Dr-Verdin/Arduino-Human-Following-Robot/README.md

# Arduino-Human-Following-Robot

## Introdução

Projeto de um Arduino Human Following Robot baseado no vídeo ["How To Make Arduino Human Following Robot"](https://www.youtube.com/watch?v=yAV5aZ0unag&t=24s) do DIY Builder.
O material utilizado está disponivel na pasta "Material".

## Lista de Componentes

| Quantidade | Componentes | Valor Unit. (R$) |
|---|---|---|
| 1 | Arduino Uno | [R$44,91](https://www.baudaeletronica.com.br/produto/arduino-uno-atmega328-smd-compativel-cabo-usb.html) |
| 1 | Motor Shield L293D | [R$19,99](https://www.baudaeletronica.com.br/produto/motor-shield-l293d-driver-ponte-h-para-arduino.html) |
| 2 | Kit motor DC 6V + roda para Robô | [R$ 13,41](https://www.baudaeletronica.com.br/produto/kit-motor-dc-roda-para-robo.html) |
| 1 | Servo Motor | [R$11,74](https://www.baudaeletronica.com.br/produto/micro-servo-9g-sg90-tower-pro.html) |
| 1 | Sensor de Distância Ultrassônico | [R$9,20](https://www.baudaeletronica.com.br/produto/sensor-de-distancia-ultrassonico-hc-sr04.html) |
| 2 | Sensor de Obstáculo Infravermelho | [R$6,30](https://www.baudaeletronica.com.br/produto/modulo-sensor-de-obstaculo-infravermelho-ir.html) |
| 2 | Kit 2 Baterias Recarregáveis 18650 3.7V-4.2V Lítio | [R$30,00](https://produto.mercadolivre.com.br/MLB-1792812106-kit-2-bateria-recarregavel-18650-37v-42v-li-ion-lanterna-_JM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) |
| 1 | Suporte para 3 Baterias de Lítio 18650 | [R$18,98](https://produto.mercadolivre.com.br/MLB-2656593580-suporte-case-para-3s-baterias-18650-126v-com-mola-e-fios-_JM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) |
| 1 | kit 40 jumpers fêmea | [R$11,40](https://www.mercadolivre.com.br/cabo-wire-jumper-fmea-x-fmea-20-cm-40pcs/p/MLB28119264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) |
| | Base de acrílico (qualquer uma serve desde que caibá os componentes) | - |
| **TOTAL**  | | R$215,64 |

**Observações:** A maioria dos componentes foi adquirido com o orientador do projeto, ou seja, muito provavelmente pode ter variações de valores em relação aos preços da tabela. 
Os componentes que tivemos que comprar foram 1 Sensor de Obstáculo Infravermelho, 1 Suporte para 3 Baterias de Lítio 18650 e o Motor Shield L293D; Além disso, tivemos que confessionar (em papelão), o "pescoço" e a "cabeça" do robô.

## Tutorial

A seguir estará o passo a passo para a montagem do robô de acordo com a nossa experiência (não necessariamente seguirá a mesma ordem do video base):

1. Primeiramente, depois de escolhermos o projeto que queriamos executar, fomos buscar alguns componentes com o orientador (Simões) da disciplina. Felizmente adquirimos a maioria dos componentes necessários para o projeto e os que faltaram compramos numa loja de eletrônica ou confeccionamos nós mesmos;
2. Já com todos os componentes necessários começamos a montagem, com a base do robô já pronta (Kit motor DC + roda para Robô e base de acrílico) fixamos o Arduino e o Suporte de Bateria em cima;
3. Logo em seguida encaixamos o Motor Shield no Arduino;
4. Começando a montagem da cabeça:
    1. Fizemos peças improvisadas de papelão para a montagem da cabeça, pois o tempo era muito curto para aprendermos à mexer com uma impressora 3D da universidade:

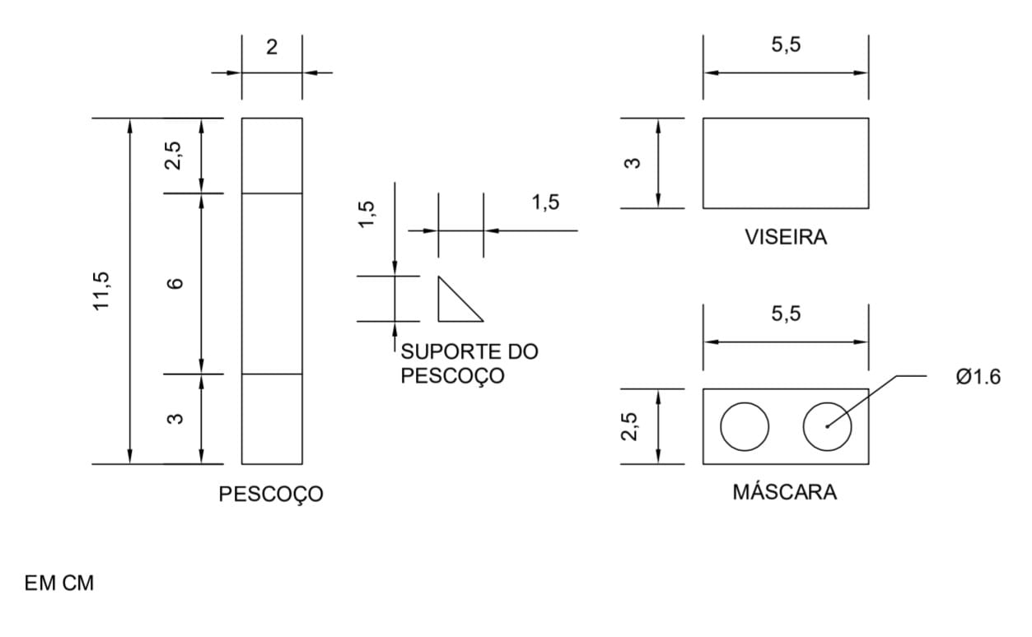
[picture p1: Material/moldes.jpeg]
    

    2. Com as peças já prontas colamos o Servo Motor na base maior do "pescoço";
    3. Para a "cabeça" encaixamos a máscara no Sensor de Distância Ultrassônico e em seguida colamos os dois Sensores de Obstáculo Infravermelhos nas laterias da máscara. Também colamos uma viseira em cima da cabeça;
    4. Com a "cabeça" e o "pescoço" prontos, colamos um no outro e depois fixamos o Servo Motor na frente da base.
5. Em seguida, já com todos os componentes fixados na base fizemos as conecções do circuito com Jumpers:

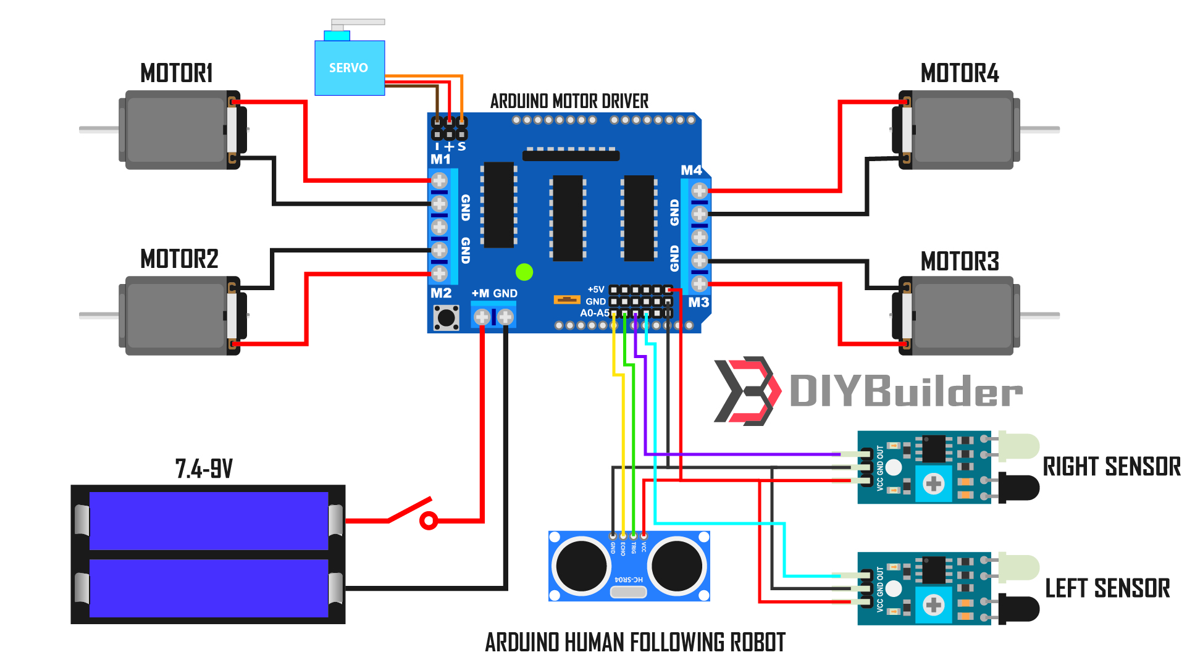
[picture p2: Material/Circuit.jpg]


6. Com todo o Hardware pronto, passamos o código para o Arduino;
7. Voilá o robô está pronto, é só inserir as baterias e se tudo estiver certo ele funcionará. Caso queira é recomendado inserir uma chave para ligar e desligar, com isso não é necessário remover as baterias para desligá-lo.

## Desafios enfretados na execução do projeto

A seguir estará listado as dificuldades que enfrentamos na realização do projeto e como solucionamos esses problemas para conseguir finalizá-lo:

- O vídeo com o projeto original tem origem indiana e foi postado à 4 anos atrás, então tivemos um pequeno trabalho para identificar os componentes e buscar semelhantes caso a necessidade pedisse; 
- Quando compramos os componentes faltantes, acabamos comprando o Suporte de Bateria igual ao do vídeo (de 2 baterias), o que foi um problema mais adiante, pois os motores da base eram de 6V (12V no total, pois só usamos dois motores DC), ou seja, precisava, no nosso caso, de um Suporte de 3 Baterias. Felizmente o nosso orientador tinha esse suporte e não precisamos comprar outro;
- O resto da montagem foi tranquila o próximo problema surgiu na hora de passar o código para o Arduino. Essa foi nossa primeira vez usando um, então tivemos adquirir um conhecimento básico, além disso modificamos o código original ao nosso favor (como o projeto original havia 4 rodas e o nosso somente 2, excluímos as duas rodas em excesso do código original. Ademais diminuímos a velocidade do robô);
- Além disso, os nossos computadores pessoais não conseguiam passar o código para o Arduino (eles não detectavam nenhuma Port), então tivemos que ir no laboratório da universidade para usar os computadores de lá para passar o nosso código;
- Depois de passarmos o código para o Arduino pensávamos que havíamos finalizado, porém esse pensamento foi ofuscado depois de inserirmos as baterias. O robô começava a girar em torno dele próprio (drift) ou corria em linha reta até bater em algum lugar, e para resolvermos esse problema levou muito tempo, tanto que no final descobrimos que o problema abrangia muito mais do que esperávamos e para resolvermos isso tivemos a ajuda de um de nossos veteranos ("Bom Dia :sun_with_face:"):
    - Uma lição muito importante que qualquer um deve saber em robótica é que ela é igual programação, a todo momento tem que ir testando para ver se tudo está correndo bem, e não saber disso foi o nosso principal erro. Antes de pedirmos ajuda para um veterano pensávamos que o problema estava no código, pois aparentemente todo o resto estava correto, mas o problema era no próprio Hardware, mais especificamente mau contato entre a cabeça e o Motor Shield e que o Sensor de Distância Ultrassônico não estava funcionando corretamente;
    - Isso foi descoberto fazendo testes com os sensores e, no momento em que percebemos que eles não estavam funcionando corretamente, descobrimos o mau contato com o Motor Shield e que o Sensor de Distância Ultrassônico estava medindo a distância errada, mesmo sem mau contato;
    - Esse sem dúvida foi o pior bug, levou muitas horas para debugá-lo, até horas de sono, pois a apresentação era no dia seguinte e estávamos ficando sem tempo, mas o robô ficou pronto algumas horas antes felizmente.

## Resultado final do projeto
### Imagens do projeto

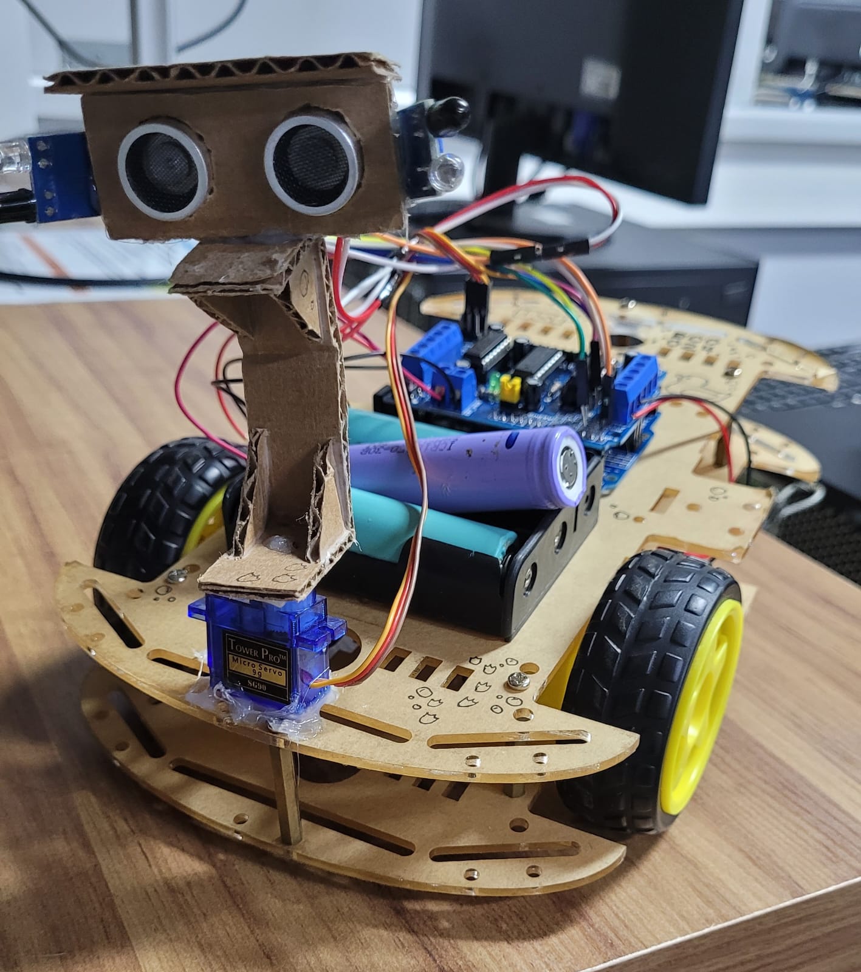
[picture p3: Material/robo_frontal.jpeg]

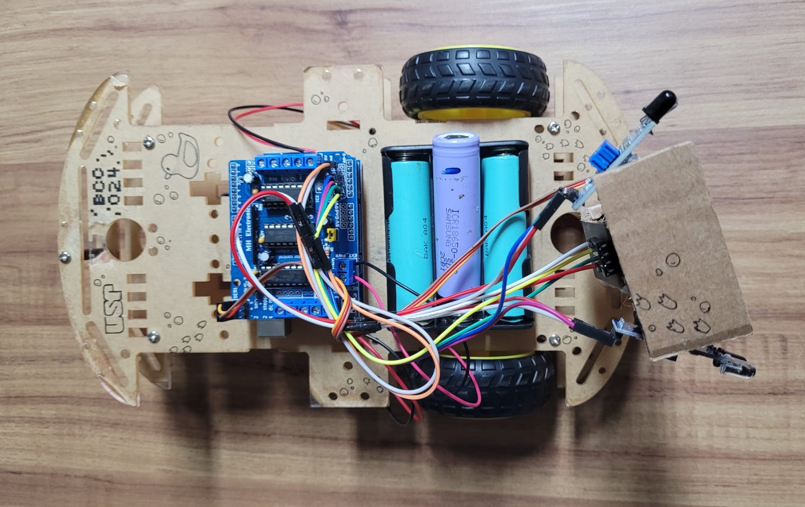
[picture p4: Material/robo_superior.jpeg]


### Vídeo do projeto

[link do vídeo no Youtube](https://youtu.be/R6QcyYe4CaU).

## Agradecimentos

Agradeço ao excelentíssimo professor Eduardo do Valle Simões, vulgo [Simões Poderoso :robot:](https://gitlab.com/simoesusp), que nos auxiliou na execução desse projeto e ao nosso veterano "[Bom Dia :sun_with_face:](https://github.com/mpferreira003)" que nos ajudou à finalizar esse projeto.

## Alunos

- Camila Piscioneri Magalhães ([Dr. Verdin :seedling:](https://github.com/Dr-Verdin)).
- Matheus Guilherme Ferreira Mendonça Learte ([Matheus-Learte :musical_note:](https://github.com/Matheus-Learte)).
