Dr-Verdin/Arduino-Human-Following-Robot/(commit log)

2024-07-06 Bom Dia
2024-07-06 Bom Dia 2.0
2024-07-06 Motor DC
